Risky-decision-making-social-study/Hardware-PCB/README.md

# rpi-header-pcb

BOM: <https://risky-decision-making-social-study.github.io/Hardware-PCB/>

pcb

## Kicad project

The kicad project situated in the `monkey-rpi-header-pcb/` folder.
