Risky-decision-making-social-study/Hardware-PCB/pdf/pcb-print.pdf

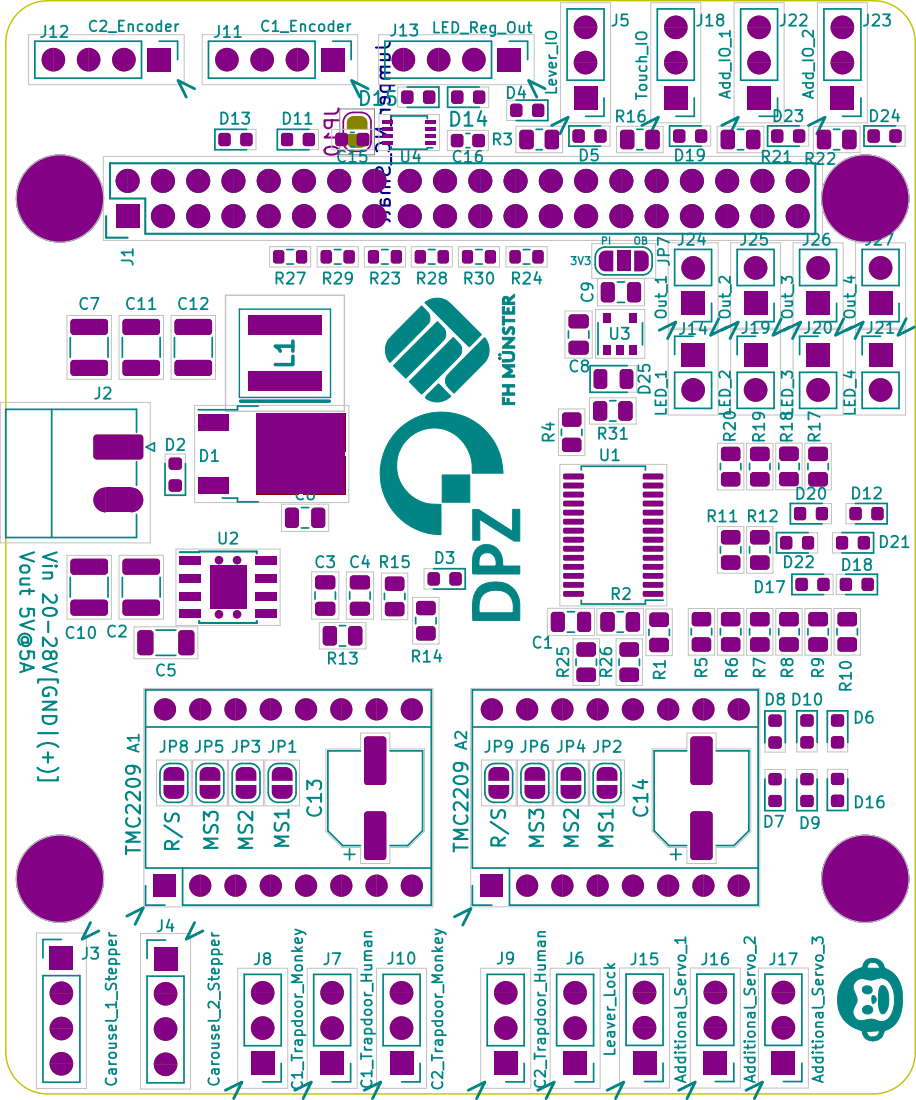
[picture p1: page 1]
