Risky-decision-making-social-study/Hardware-PCB/pdf/pcb-print_BC.pdf

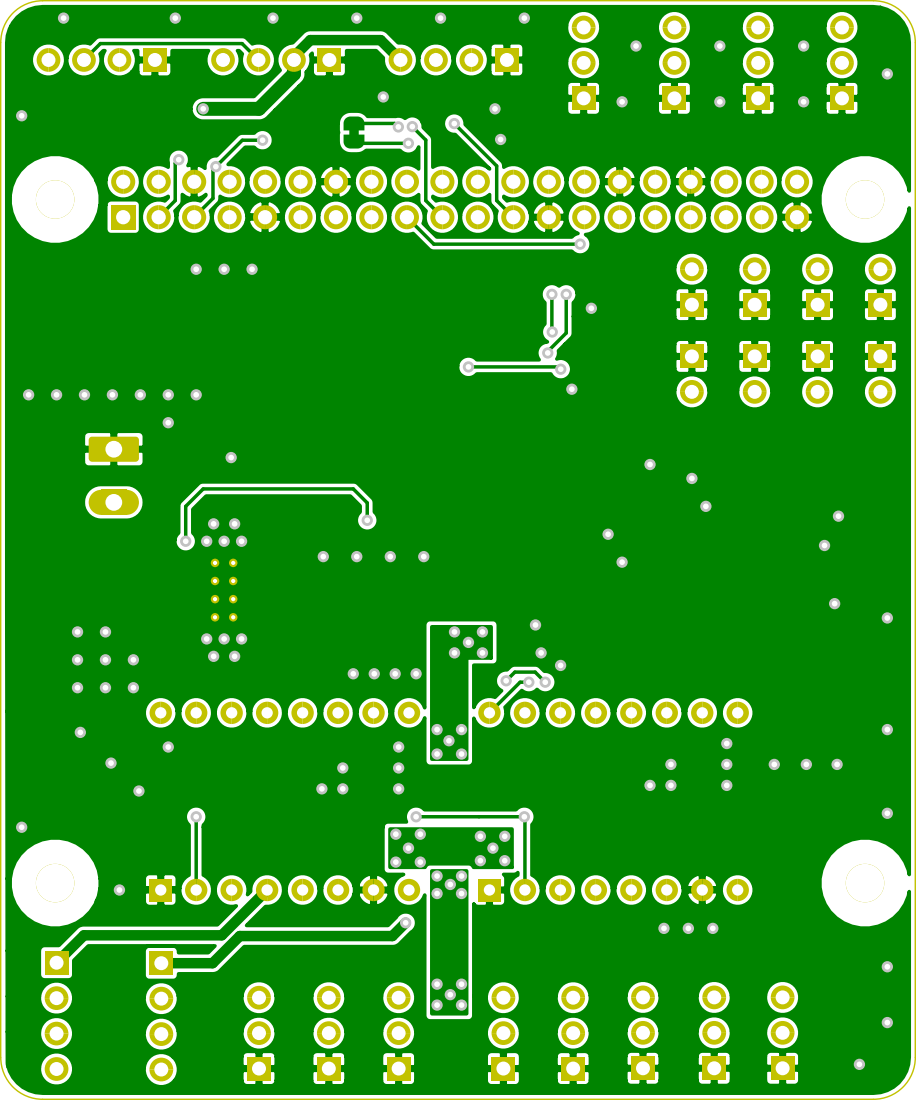
[picture p2: page 1]
