Risky-decision-making-social-study/Hardware-PCB/pdf/pcb-print_FC.pdf

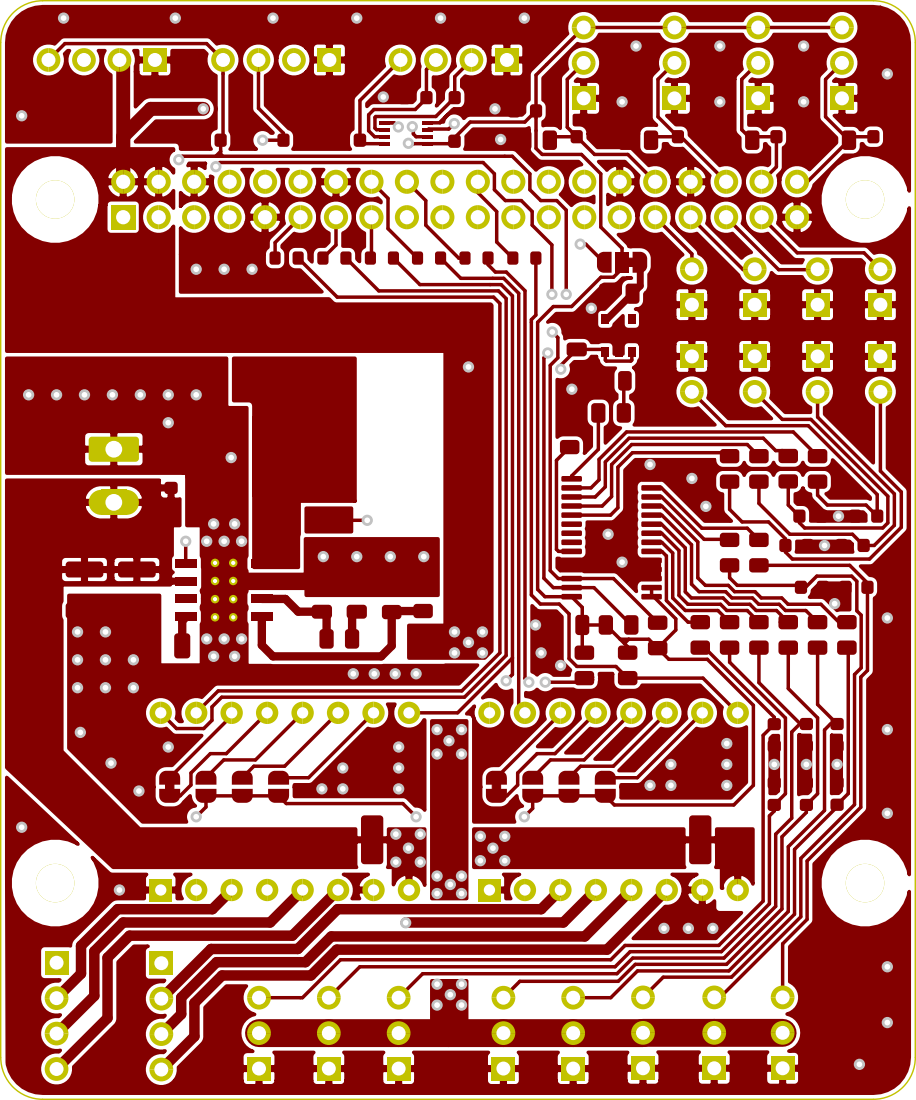
[picture p3: page 1]
