Risky-decision-making-social-study/Hardware-PCB/monkey-rpi-header-pcb/monkey-rpi-header-pcb.kicad_pcb

## KiCad design monkey-rpi-header-pcb/monkey-rpi-header-pcb.kicad_pcb (2023-11-08)

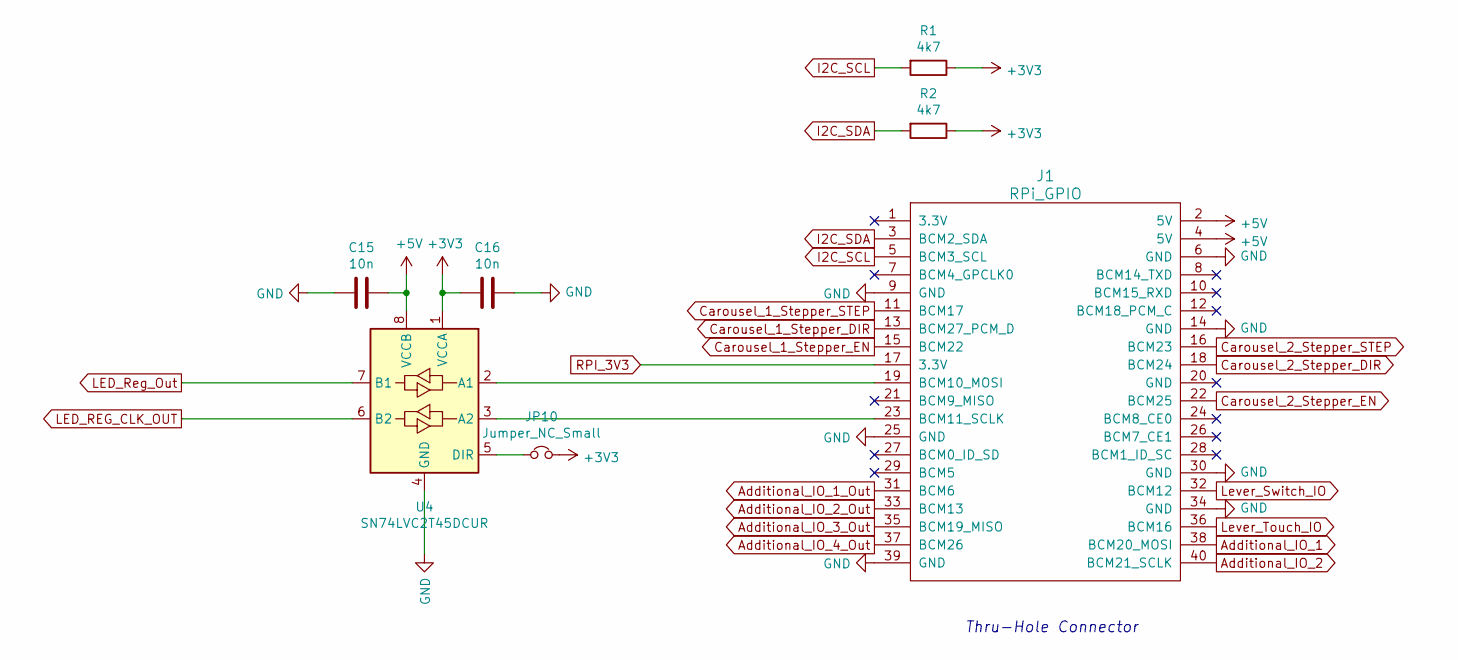
[picture p10: schematic RPi_GPIO.sch]

Parts:
C15, C16: 10n; C_0603_1608Metric; Part CL10B103KB8NNNC
J1: RPi_GPIO; Pin_Header_Straight_2x20; Part PRT-14017
JP10: Jumper_NC_Small; SolderJumper-2_P1.3mm_Bridged_RoundedPad1.0x1.5mm
R1, R2: 4k7; R_0805_2012Metric; Part CRCW08054K70FKEAC
U4: SN74LVC2T45DCUR; VSSOP-8_2.4x2.1mm_P0.5mm

Connections:
+5V: C15.1, J1.2 (5V), J1.4 (5V), U4.8 (VCCB); also elsewhere on the board
Additional_IO_1: J1.38 (BCM20_MOSI); also elsewhere on the board
Additional_IO_1_Out: J1.31 (BCM6); also elsewhere on the board
Additional_IO_2: J1.40 (BCM21_SCLK); also elsewhere on the board
Additional_IO_2_Out: J1.33 (BCM13); also elsewhere on the board
Additional_IO_3_Out: J1.35 (BCM19_MISO); also elsewhere on the board
Additional_IO_4_Out: J1.37 (BCM26); also elsewhere on the board
Carousel_1_Stepper_DIR: J1.13 (BCM27_PCM_D); also elsewhere on the board
Carousel_1_Stepper_EN: J1.15 (BCM22); also elsewhere on the board
Carousel_1_Stepper_STEP: J1.11 (BCM17); also elsewhere on the board
Carousel_2_Stepper_DIR: J1.18 (BCM24); also elsewhere on the board
Carousel_2_Stepper_EN: J1.22 (BCM25); also elsewhere on the board
Carousel_2_Stepper_STEP: J1.16 (BCM23); also elsewhere on the board
GND: C15.2, C16.1, J1.6 (GND), J1.9 (GND), J1.14 (GND), J1.25 (GND), J1.30 (GND), J1.34 (GND), J1.39 (GND), U4.4 (GND); also elsewhere on the board
I2C_SCL: J1.5 (BCM3_SCL), R1.2; also elsewhere on the board
I2C_SDA: J1.3 (BCM2_SDA), R2.2; also elsewhere on the board
LED_REG_CLK_OUT: U4.6 (B2); also elsewhere on the board
LED_Reg_Out: U4.7 (B1); also elsewhere on the board
Lever_Switch_IO: J1.32 (BCM12); also elsewhere on the board
Lever_Touch_IO: J1.36 (BCM16); also elsewhere on the board
unnamed: J1.19 (BCM10_MOSI), U4.2 (A1)
unnamed: J1.23 (BCM11_SCLK), U4.3 (A2)
unnamed: JP10.1, U4.5 (DIR)
RPI_3V3: J1.17 (3.3V); also elsewhere on the board

Notes on the sheet:
Thru-Hole Connector

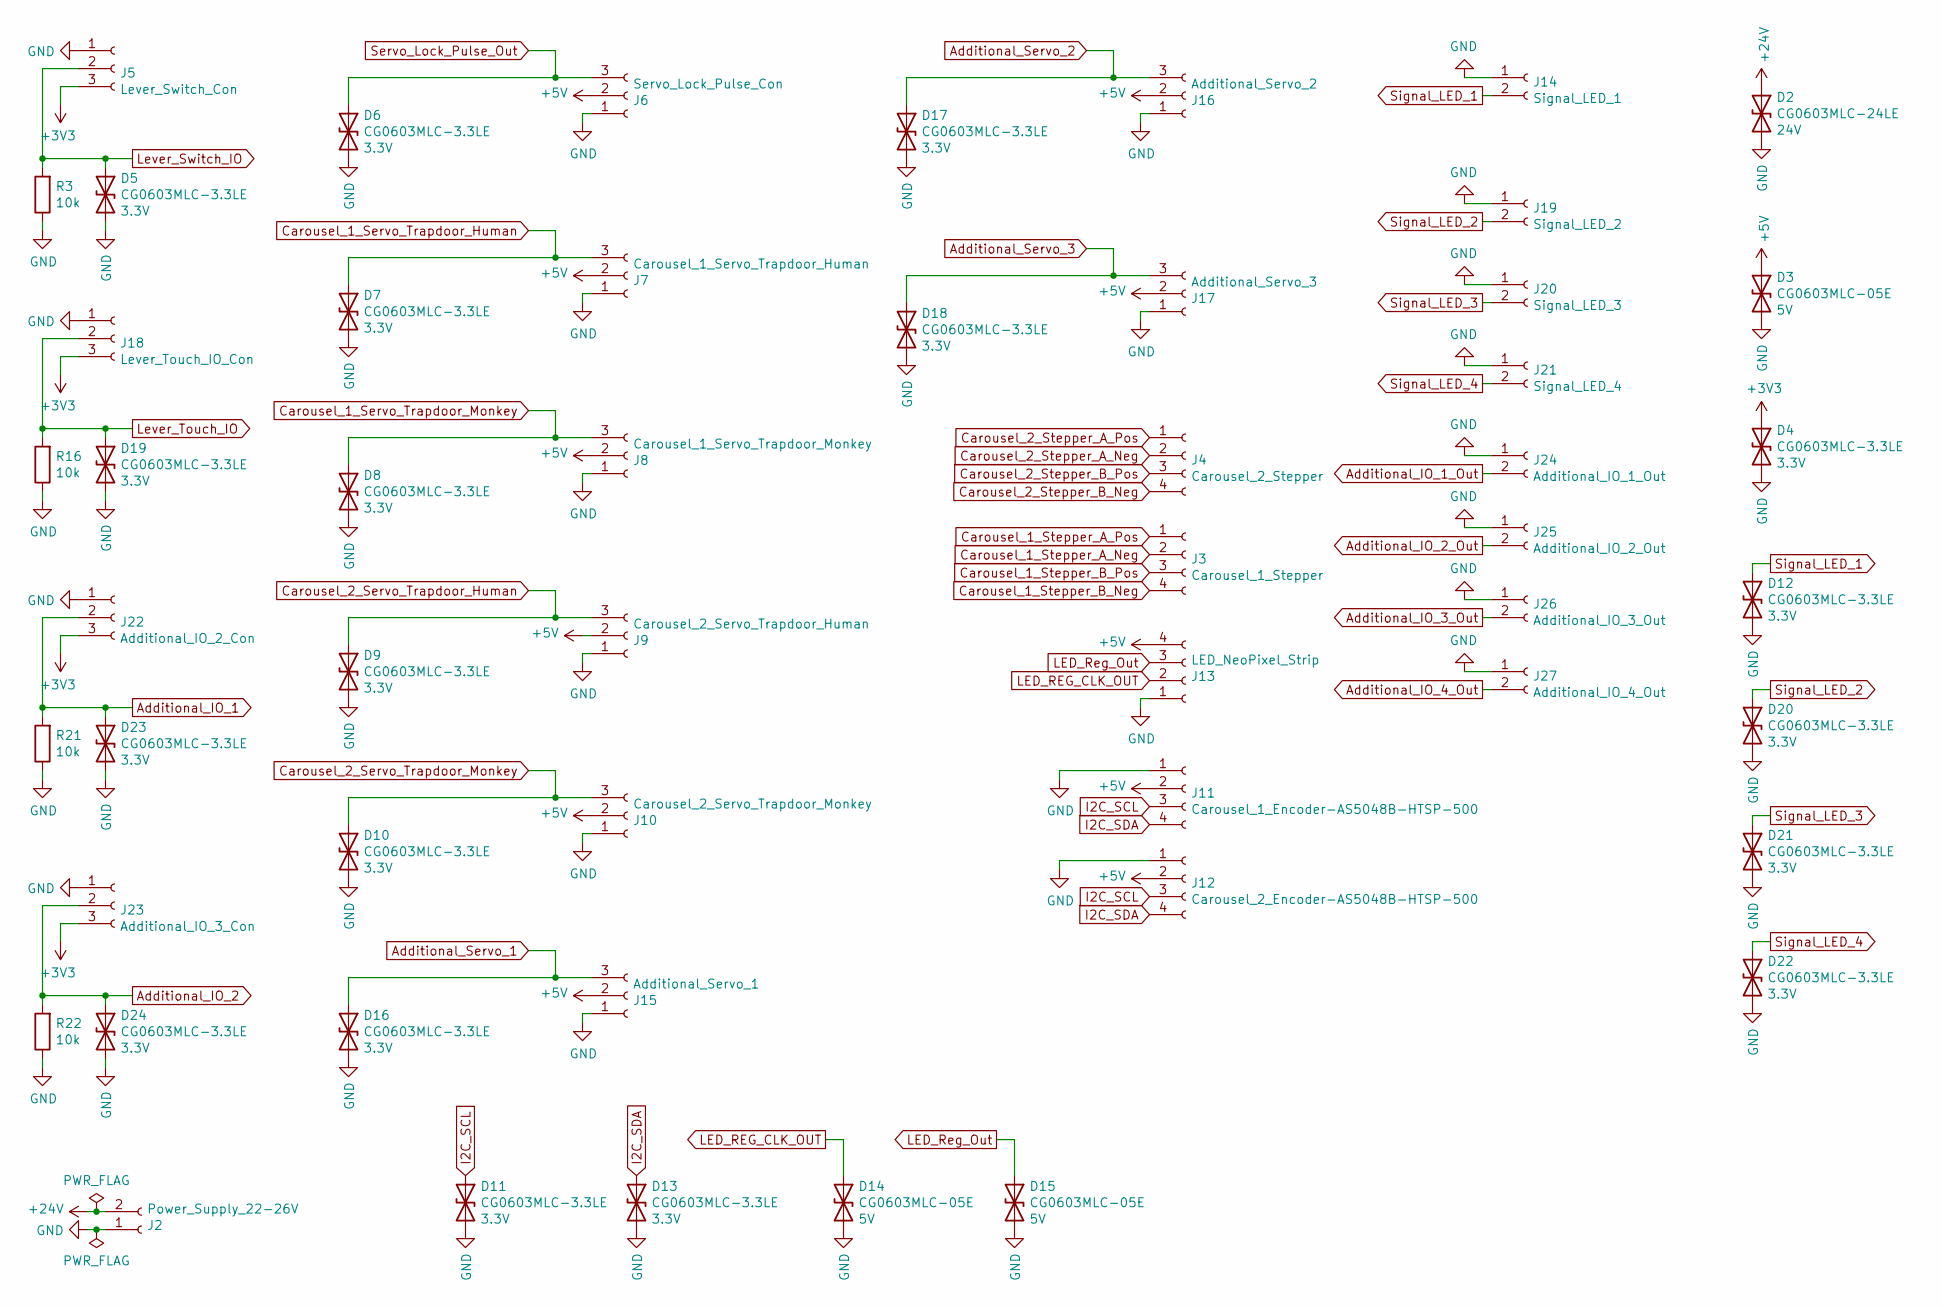
[picture p11: schematic Shield_IO.sch]

Parts:
D2: CG0603MLC-24LE; D_0603_1608Metric; Part CG0603MLC-24LE
D3, D14, D15: CG0603MLC-05E; D_0603_1608Metric; Part CG0603MLC-05E
D4, D5, D6, D7, D8, D9, D10, D11, D12, D13, D16, D17, D18, D19, D20, D21, D22, D23, D24: CG0603MLC-3.3LE; D_0603_1608Metric; Part CG0603MLC-3.3LE
J2: Power_Supply_22-26V; PhoenixContact_MC_1,5_2-G-3.81_1x02_P3.81mm_Horizontal; Part 1803277 und 1803578
J3: Carousel_1_Stepper; PinHeader_1x04_P2.54mm_Vertical
J4: Carousel_2_Stepper; PinHeader_1x04_P2.54mm_Vertical
J5: Lever_Switch_Con; PinHeader_1x03_P2.54mm_Vertical; Part PPTC021LFBN-RC
J6: Servo_Lock_Pulse_Con; PinHeader_1x03_P2.54mm_Vertical
J7: Carousel_1_Servo_Trapdoor_Human; PinHeader_1x03_P2.54mm_Vertical
J8: Carousel_1_Servo_Trapdoor_Monkey; PinHeader_1x03_P2.54mm_Vertical
J9: Carousel_2_Servo_Trapdoor_Human; PinHeader_1x03_P2.54mm_Vertical
J10: Carousel_2_Servo_Trapdoor_Monkey; PinHeader_1x03_P2.54mm_Vertical
J11: Carousel_1_Encoder-AS5048B-HTSP-500; PinHeader_1x04_P2.54mm_Vertical
J12: Carousel_2_Encoder-AS5048B-HTSP-500; PinHeader_1x04_P2.54mm_Vertical
J13: LED_NeoPixel_Strip; PinHeader_1x04_P2.54mm_Vertical
J14: Signal_LED_1; PinHeader_1x02_P2.54mm_Vertical
J15: Additional_Servo_1; PinHeader_1x03_P2.54mm_Vertical
J16: Additional_Servo_2; PinHeader_1x03_P2.54mm_Vertical
J17: Additional_Servo_3; PinHeader_1x03_P2.54mm_Vertical
J18: Lever_Touch_IO_Con; PinHeader_1x03_P2.54mm_Vertical; Part PPTC021LFBN-RC
J19: Signal_LED_2; PinHeader_1x02_P2.54mm_Vertical
J20: Signal_LED_3; PinHeader_1x02_P2.54mm_Vertical
J21: Signal_LED_4; PinHeader_1x02_P2.54mm_Vertical
J22: Additional_IO_2_Con; PinHeader_1x03_P2.54mm_Vertical; Part PPTC021LFBN-RC
J23: Additional_IO_3_Con; PinHeader_1x03_P2.54mm_Vertical; Part PPTC021LFBN-RC
J24: Additional_IO_1_Out; PinHeader_1x02_P2.54mm_Vertical
J25: Additional_IO_2_Out; PinHeader_1x02_P2.54mm_Vertical
J26: Additional_IO_3_Out; PinHeader_1x02_P2.54mm_Vertical
J27: Additional_IO_4_Out; PinHeader_1x02_P2.54mm_Vertical
R3, R16, R21, R22: 10k; R_0805_2012Metric; Part CRCW080510K0FKEAC

Connections:
+5V: D3.1 (A1), J6.2, J7.2, J8.2, J9.2, J10.2, J11.2, J12.2, J13.4, J15.2, J16.2, J17.2; also elsewhere on the board
+24V: D2.1 (A1), J2.2; also elsewhere on the board
Additional_IO_1: D23.1 (A1), J22.2, R21.2; also elsewhere on the board
Additional_IO_1_Out: J24.2; also elsewhere on the board
Additional_IO_2: D24.1 (A1), J23.2, R22.2; also elsewhere on the board
Additional_IO_2_Out: J25.2; also elsewhere on the board
Additional_IO_3_Out: J26.2; also elsewhere on the board
Additional_IO_4_Out: J27.2; also elsewhere on the board
Additional_Servo_1: D16.1 (A1), J15.3; also elsewhere on the board
Additional_Servo_2: D17.1 (A1), J16.3; also elsewhere on the board
Additional_Servo_3: D18.1 (A1), J17.3; also elsewhere on the board
Carousel_1_Servo_Trapdoor_Human: D7.1 (A1), J7.3; also elsewhere on the board
Carousel_1_Servo_Trapdoor_Monkey: D8.1 (A1), J8.3; also elsewhere on the board
Carousel_1_Stepper_A_Neg: J3.2; also elsewhere on the board
Carousel_1_Stepper_A_Pos: J3.1; also elsewhere on the board
Carousel_1_Stepper_B_Neg: J3.4; also elsewhere on the board
Carousel_1_Stepper_B_Pos: J3.3; also elsewhere on the board
Carousel_2_Servo_Trapdoor_Human: D9.1 (A1), J9.3; also elsewhere on the board
Carousel_2_Servo_Trapdoor_Monkey: D10.1 (A1), J10.3; also elsewhere on the board
Carousel_2_Stepper_A_Neg: J4.2; also elsewhere on the board
Carousel_2_Stepper_A_Pos: J4.1; also elsewhere on the board
Carousel_2_Stepper_B_Neg: J4.4; also elsewhere on the board
Carousel_2_Stepper_B_Pos: J4.3; also elsewhere on the board
GND: D2.2 (A2), D3.2 (A2), D4.2 (A2), D5.2 (A2), D6.2 (A2), D7.2 (A2), D8.2 (A2), D9.2 (A2), D10.2 (A2), D11.2 (A2), D12.2 (A2), D13.2 (A2), D14.2 (A2), D15.2 (A2), D16.2 (A2), D17.2 (A2), D18.2 (A2), D19.2 (A2), D20.2 (A2), D21.2 (A2), D22.2 (A2), D23.2 (A2), D24.2 (A2), J2.1, J5.1, J6.1, J7.1, J8.1, J9.1, J10.1, J11.1, J12.1, J13.1, J14.1, J15.1, J16.1, J17.1, J18.1, J19.1, J20.1, J21.1, J22.1, J23.1, J24.1, J25.1, J26.1, J27.1, R3.1, R16.1, R21.1, R22.1; also elsewhere on the board
I2C_SCL: D11.1 (A1), J11.3, J12.3; also elsewhere on the board
I2C_SDA: D13.1 (A1), J11.4, J12.4; also elsewhere on the board
LED_REG_CLK_OUT: D14.1 (A1), J13.2; also elsewhere on the board
LED_Reg_Out: D15.1 (A1), J13.3; also elsewhere on the board
Lever_Switch_IO: D5.1 (A1), J5.2, R3.2; also elsewhere on the board
Lever_Touch_IO: D19.1 (A1), J18.2, R16.2; also elsewhere on the board
Servo_Lock_Pulse_Out: D6.1 (A1), J6.3; also elsewhere on the board
Signal_LED_1: D12.1 (A1), J14.2; also elsewhere on the board
Signal_LED_2: D20.1 (A1), J19.2; also elsewhere on the board
Signal_LED_3: D21.1 (A1), J20.2; also elsewhere on the board
Signal_LED_4: D22.1 (A1), J21.2; also elsewhere on the board

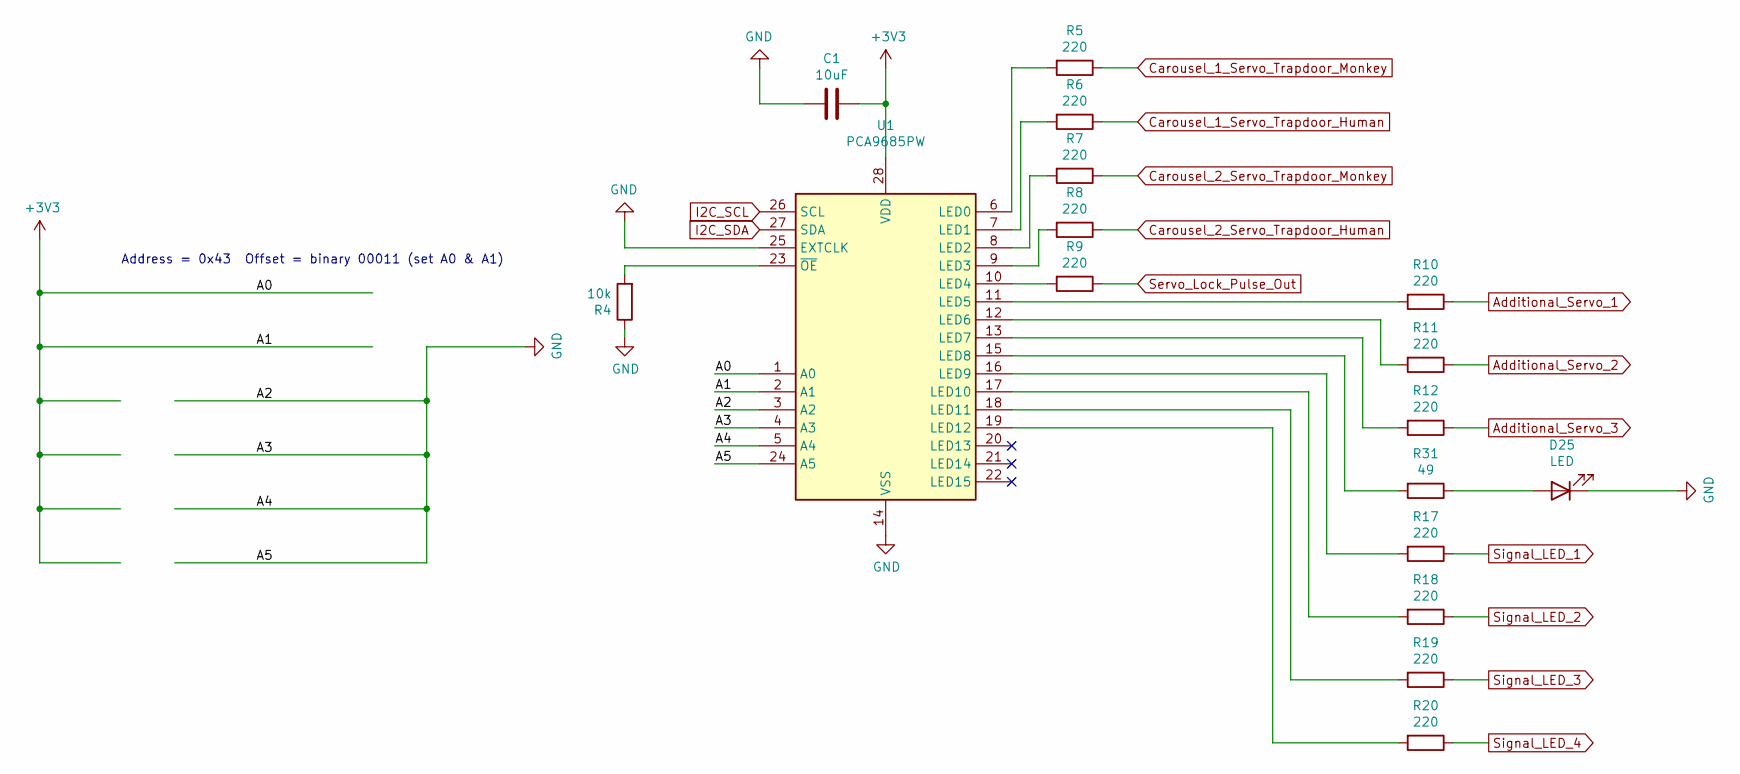
[picture p12: schematic PWM_Out.sch]

Parts:
C1: 10uF; C_0805_2012Metric; Part CL21A106KQCLRNC
D25: LED; LED_0805_2012Metric; Part 150080RS75000
R4: 10k; R_0805_2012Metric; Part CRCW080510K0FKEAC
R5, R6, R7, R8, R9, R10, R11, R12, R17, R18, R19, R20: 220; R_0805_2012Metric; Part CRCW0805220RFKEAC
R31: 49; R_0805_2012Metric; Part RC0805FR-0749R9L
U1: PCA9685PW; TSSOP-28_4.4x9.7mm_P0.65mm; Part PCA9685PW,118

Connections:
Additional_Servo_1: R10.1; also elsewhere on the board
Additional_Servo_2: R11.1; also elsewhere on the board
Additional_Servo_3: R12.1; also elsewhere on the board
Carousel_1_Servo_Trapdoor_Human: R6.1; also elsewhere on the board
Carousel_1_Servo_Trapdoor_Monkey: R5.1; also elsewhere on the board
Carousel_2_Servo_Trapdoor_Human: R8.1; also elsewhere on the board
Carousel_2_Servo_Trapdoor_Monkey: R7.1; also elsewhere on the board
GND: C1.2, D25.1 (K), R4.1, U1.3 (A2), U1.4 (A3), U1.5 (A4), U1.14 (VSS), U1.24 (A5), U1.25 (EXTCLK); also elsewhere on the board
I2C_SCL: U1.26 (SCL); also elsewhere on the board
I2C_SDA: U1.27 (SDA); also elsewhere on the board
unnamed: D25.2 (A), R31.1
unnamed: R4.2, U1.23 (~OE)
unnamed: R5.2, U1.6 (LED0)
unnamed: R6.2, U1.7 (LED1)
unnamed: R7.2, U1.8 (LED2)
unnamed: R8.2, U1.9 (LED3)
unnamed: R9.2, U1.10 (LED4)
unnamed: R10.2, U1.11 (LED5)
unnamed: R11.2, U1.12 (LED6)
unnamed: R12.2, U1.13 (LED7)
unnamed: R17.2, U1.16 (LED9)
unnamed: R18.2, U1.17 (LED10)
unnamed: R19.2, U1.18 (LED11)
unnamed: R20.2, U1.19 (LED12)
unnamed: R31.2, U1.15 (LED8)
Servo_Lock_Pulse_Out: R9.1; also elsewhere on the board
Signal_LED_1: R17.1; also elsewhere on the board
Signal_LED_2: R18.1; also elsewhere on the board
Signal_LED_3: R19.1; also elsewhere on the board
Signal_LED_4: R20.1; also elsewhere on the board

Notes on the sheet:
Address = 0x43 Offset = binary 00011 (set A0 & A1)

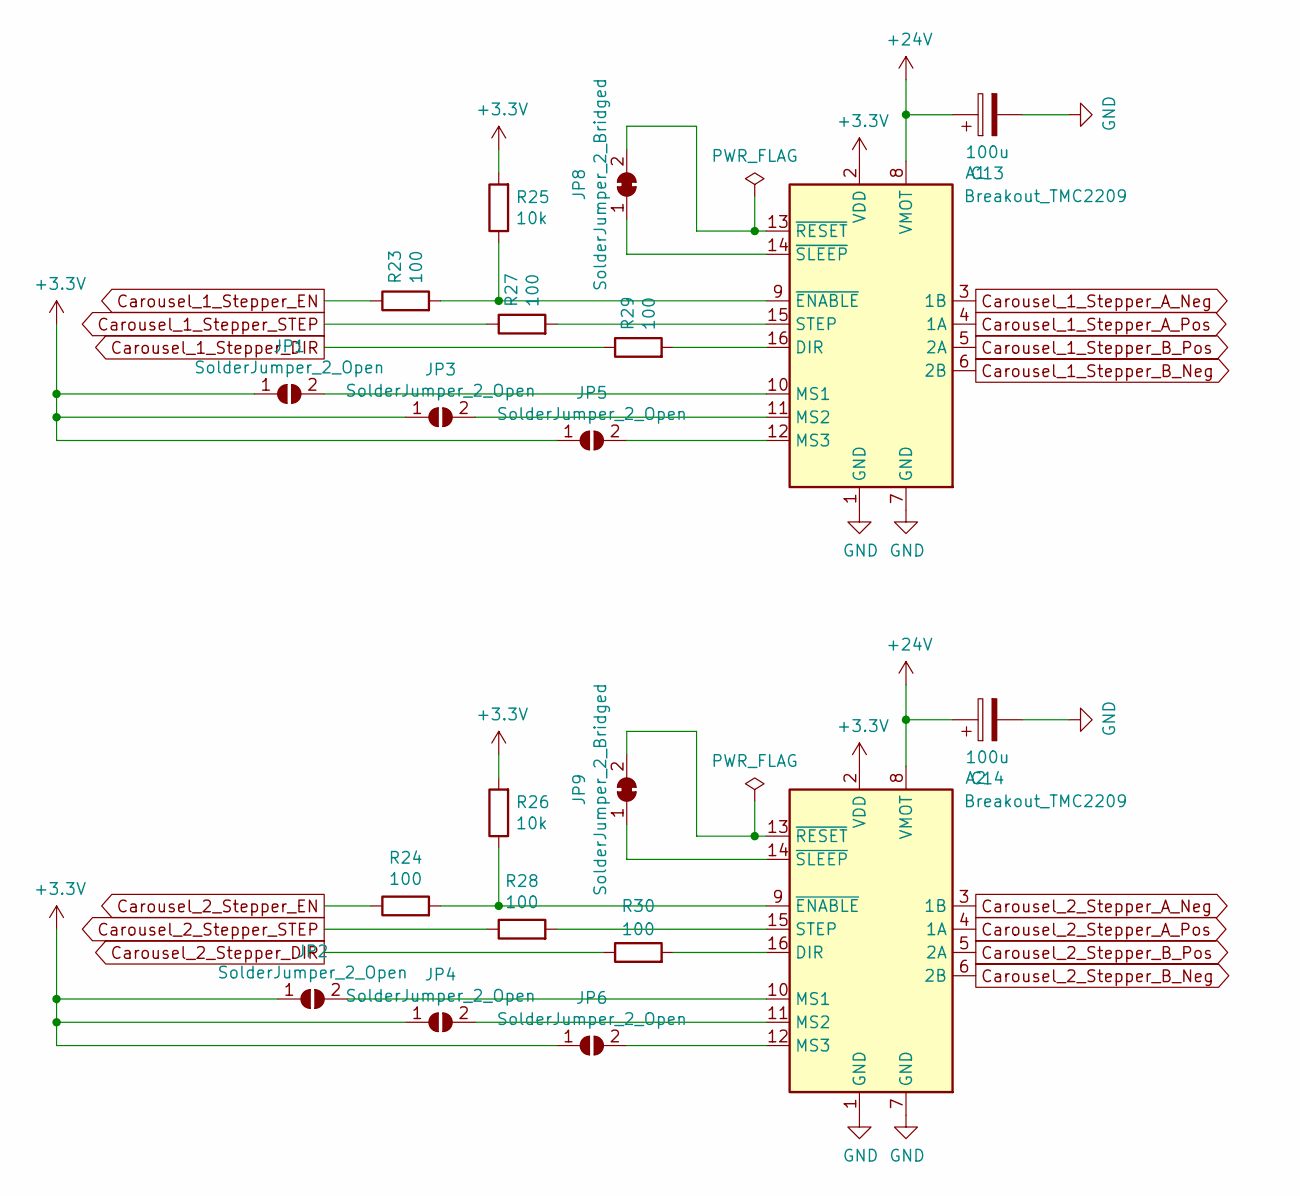
[picture p13: schematic stepper.sch]

Parts:
A1, A2: Breakout_TMC2209; Pololu_Breakout-16_15.2x20.3mm
C13, C14: 100u; CP_Elec_6.3x7.7; Part EEE-FT1V101AP
JP1, JP2, JP3, JP4, JP5, JP6: SolderJumper_2_Open; SolderJumper-2_P1.3mm_Open_RoundedPad1.0x1.5mm
JP8, JP9: SolderJumper_2_Bridged; SolderJumper-2_P1.3mm_Bridged_RoundedPad1.0x1.5mm
R23, R24, R27, R28, R29, R30: 100; R_0603_1608Metric; Part CRCW0603100RFKEAC
R25, R26: 10k; R_0805_2012Metric; Part CRCW080510K0FKEAC

Connections:
+24V: A1.8 (VMOT), A2.8 (VMOT), C13.1, C14.1; also elsewhere on the board
Carousel_1_Stepper_A_Neg: A1.3 (1B); also elsewhere on the board
Carousel_1_Stepper_A_Pos: A1.4 (1A); also elsewhere on the board
Carousel_1_Stepper_B_Neg: A1.6 (2B); also elsewhere on the board
Carousel_1_Stepper_B_Pos: A1.5 (2A); also elsewhere on the board
Carousel_1_Stepper_DIR: R29.1; also elsewhere on the board
Carousel_1_Stepper_EN: R23.1; also elsewhere on the board
Carousel_1_Stepper_STEP: R27.1; also elsewhere on the board
Carousel_2_Stepper_A_Neg: A2.3 (1B); also elsewhere on the board
Carousel_2_Stepper_A_Pos: A2.4 (1A); also elsewhere on the board
Carousel_2_Stepper_B_Neg: A2.6 (2B); also elsewhere on the board
Carousel_2_Stepper_B_Pos: A2.5 (2A); also elsewhere on the board
Carousel_2_Stepper_DIR: R30.1; also elsewhere on the board
Carousel_2_Stepper_EN: R24.1; also elsewhere on the board
Carousel_2_Stepper_STEP: R28.1; also elsewhere on the board
GND: A1.1 (GND), A1.7 (GND), A2.1 (GND), A2.7 (GND), C13.2, C14.2; also elsewhere on the board
unnamed: A1.9 (~ENABLE), R23.2, R25.1
unnamed: A1.10 (MS1), JP1.2 (B)
unnamed: A1.11 (MS2), JP3.2 (B)
unnamed: A1.12 (MS3), JP5.2 (B)
unnamed: A1.13 (~RESET), JP8.2 (B)
unnamed: A1.14 (~SLEEP), JP8.1 (A)
unnamed: A1.15 (STEP), R27.2
unnamed: A1.16 (DIR), R29.2
unnamed: A2.9 (~ENABLE), R24.2, R26.1
unnamed: A2.10 (MS1), JP2.2 (B)
unnamed: A2.11 (MS2), JP4.2 (B)
unnamed: A2.12 (MS3), JP6.2 (B)
unnamed: A2.13 (~RESET), JP9.2 (B)
unnamed: A2.14 (~SLEEP), JP9.1 (A)
unnamed: A2.15 (STEP), R28.2
unnamed: A2.16 (DIR), R30.2

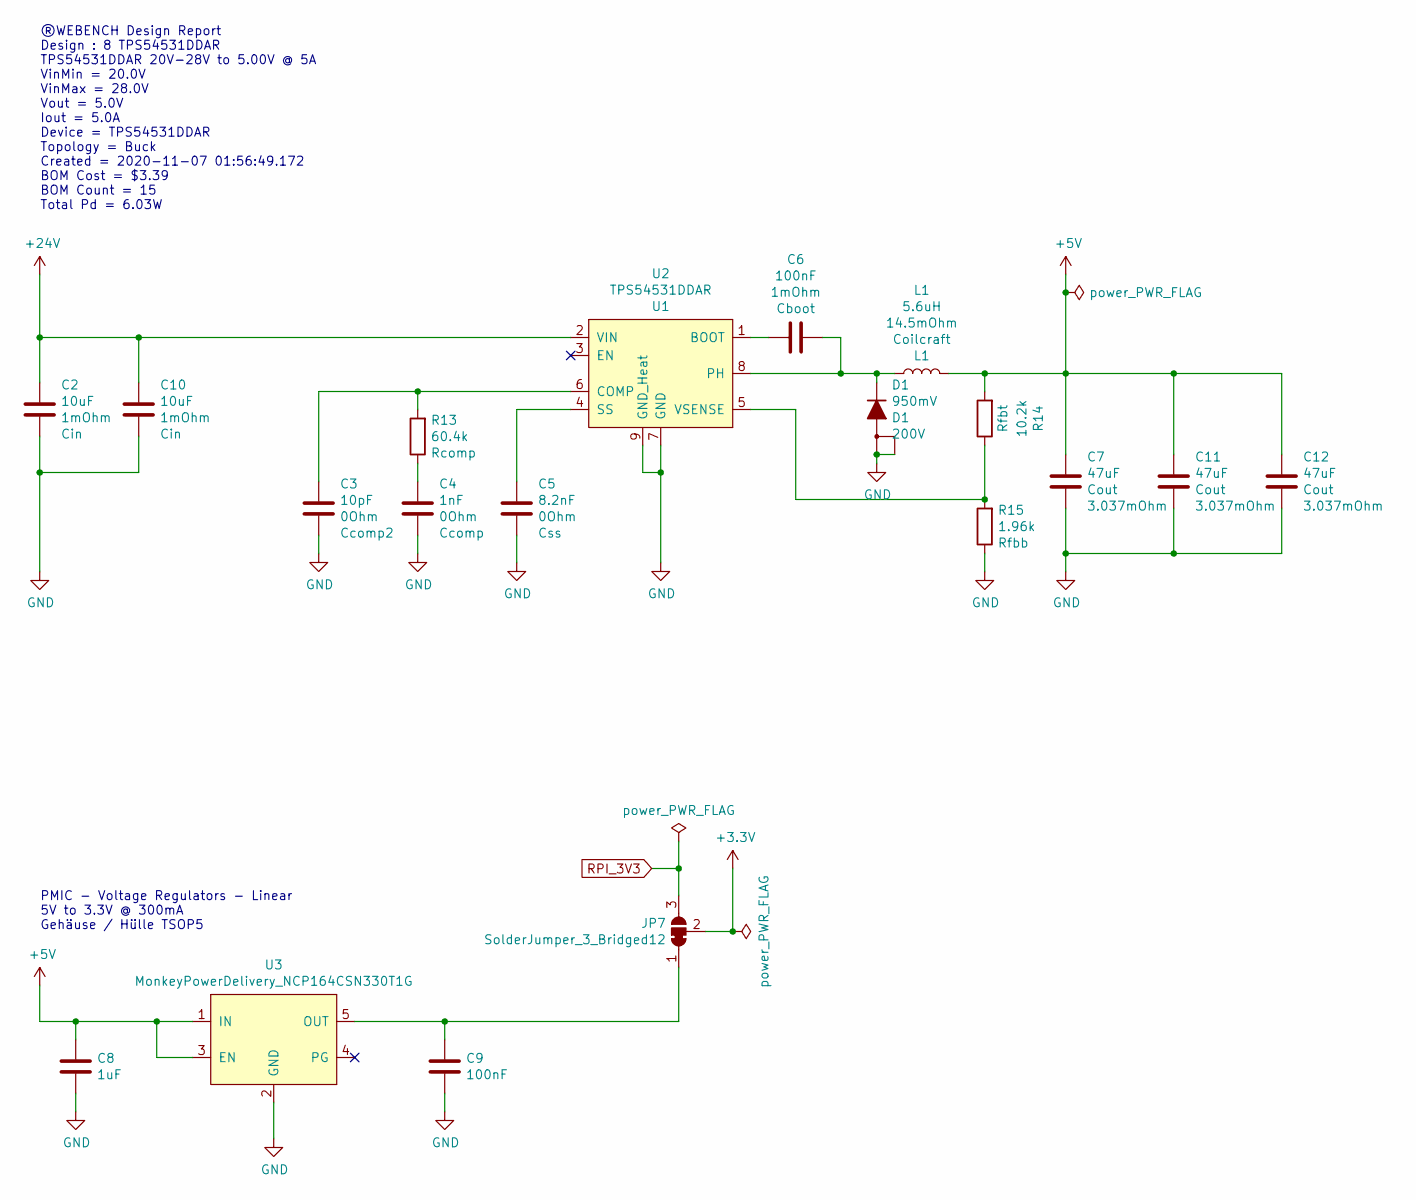
[picture p14: schematic SupplyPower.sch]

Parts:
C2, C10: 10uF; C_1210_3225Metric; Part C3225X7R1H106M250AC
C3: 10pF; C_0805_2012Metric; Part CL21C100JBANNNC
C4: 1nF; C_0805_2012Metric; Part GRM2165C1H102JA01J
C5: 8.2nF; C_1206_3216Metric; Part 12063A822JAT2A
C6, C9: 100nF; C_0805_2012Metric; Part CC0805KRX7R7BB104
C7, C11, C12: 47uF; C_1210_3225Metric; Part GRM32ER61C476KE15L
C8: 1uF; C_0805_2012Metric; Part CL21B105KOFNNNG
D1: 950mV; TO-252-2; Part SBRD10200TR
JP7: SolderJumper_3_Bridged12; SolderJumper-3_P1.3mm_Bridged12_RoundedPad1.0x1.5mm_NumberL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
L1: 5.6uH; XAL6060562MEB; Part XAL6060-562MEB
R13: 60.4k; R_0805_2012Metric; Part CRCW080560K4FKEA
R14: 10.2k; R_0805_2012Metric; Part CRCW080510K2FKEA
R15: 1.96k; R_0805_2012Metric; Part CRCW08051K96FKEA
U2: TPS54531DDAR; Texas_HSOP-8-1EP_3.9x4.9mm_P1.27mm_ThermalVias; Part TPS54531DDAR
U3: MonkeyPowerDelivery_NCP164CSN330T1G; TSOP-5_1.65x3.05mm_P0.95mm; Part NCP164CSN330T1G

Connections:
+5V: C7.2, C8.1, C11.2, C12.2, L1.2, R14.2, U3.1 (IN), U3.3 (EN); also elsewhere on the board
+24V: C2.2, C10.2, U2.2 (VIN); also elsewhere on the board
GND: C2.1, C3.1, C4.1, C5.1, C7.1, C8.2, C9.2, C10.1, C11.1, C12.1, D1.1 (A1), D1.3 (A2), R15.1, U2.7 (GND), U2.9 (GND_Heat), U3.2 (GND); also elsewhere on the board
unnamed: C3.2, R13.2, U2.6 (COMP)
unnamed: C4.2, R13.1
unnamed: C5.2, U2.4 (SS)
unnamed: C6.1, D1.2 (K), L1.1, U2.8 (PH)
unnamed: C6.2, U2.1 (BOOT)
unnamed: C9.1, JP7.1 (A), U3.5 (OUT)
unnamed: R14.1, R15.2, U2.5 (VSENSE)
RPI_3V3: JP7.3 (B); also elsewhere on the board

Notes on the sheet:
®WEBENCH Design Report Design : 8 TPS54531DDAR TPS54531DDAR 20V-28V to 5.00V @ 5A VinMin = 20.0V VinMax = 28.0V Vout = 5.0V Iout = 5.0A Device = TPS54531DDAR Topology = Buck Created = 2020-11-07 01:56:49.172 BOM Cost = $3.39 BOM Count = 15 Total Pd = 6.03W
PMIC - Voltage Regulators - Linear 5V to 3.3V @ 300mA Gehäuse / Hülle TSOP5

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
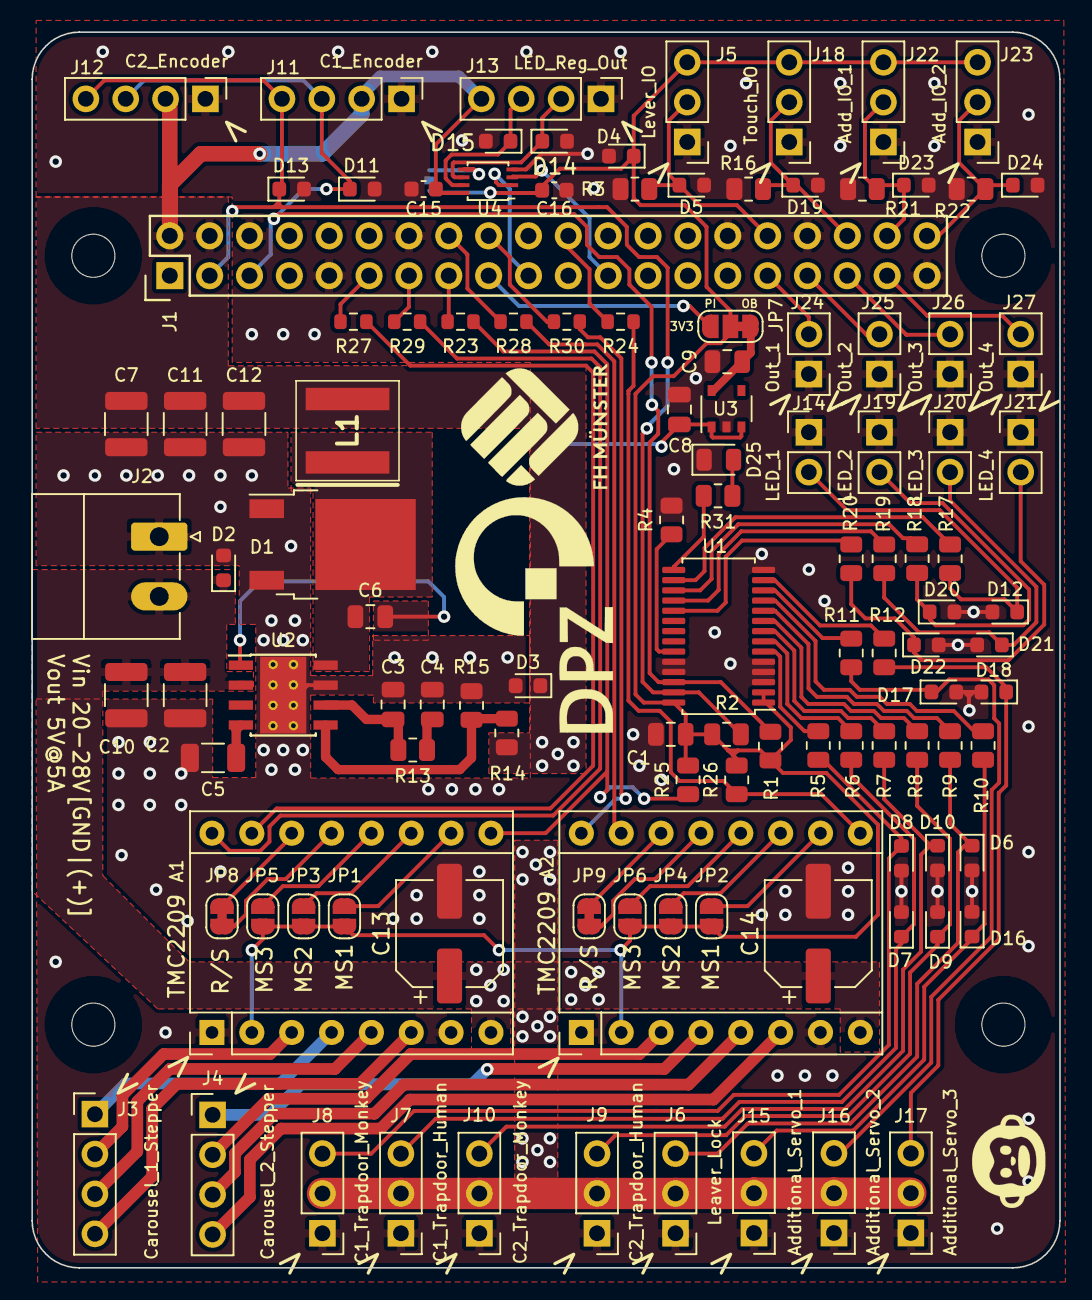
[picture p15: board monkey-rpi-header-pcb.kicad_pcb from above]

Board: 2 copper layers, 65.5 x 78.8 mm, 119 parts (1 on the bottom side), 84 nets.

Other parts of the board:
Ref**: Val**; monkey-drawing
Ref**#2: Val**; FH_silk
Ref**#3: Val**; DPZ_SilkS
